deco42/lcb-retrofit/3d-prints/rail_end_cap.stl

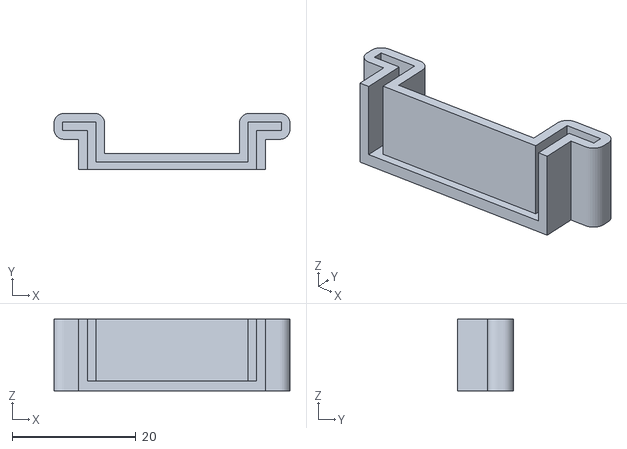
[picture p1: CAD file, 2026-10-27]
3d-prints/rail_end_cap.stl
38.2 x 9.10 x 11.6
