deco42/lcb-retrofit/3d-prints/db37_rail_holder.stl

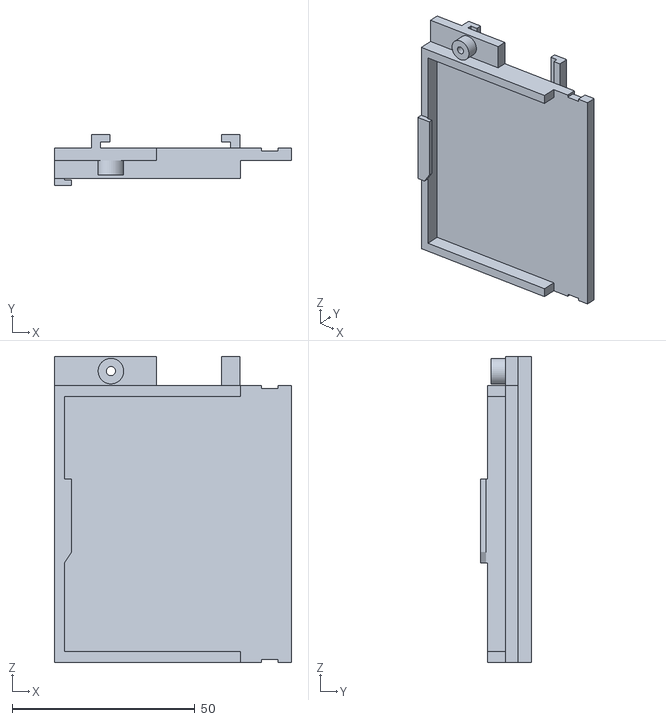
[picture p2: CAD file, 2026-10-27]
3d-prints/db37_rail_holder.stl
65.0 x 13.8 x 83.8
