deco42/lcb-retrofit/testdata/cybelec_link.vectors.txt

# initial state: (raw 0x104, all flags 1, p20 = p28 = 0, station angle 0)
# status
rx 00 ack 1 tx 00 01 00 00 00 00 00 34 00
rx 10 ack 0 tx 10 00
rx 11 ack 0 tx 10 00
rx 12 ack 0 tx 10 00
rx 13 ack 0 tx 10 00
rx 14 ack 0 tx 10 00
rx 15 ack 0 tx 10 00
rx 16 ack 0 tx 10 00
rx 17 ack 0 tx 10 00
rx 18 ack 0 tx 10 00
rx 19 ack 0 tx 10 00
rx 1a ack 0 tx 10 00
rx 1b ack 0 tx 10 00
rx 1c ack 0 tx 10 00
rx 1d ack 0 tx 10 00
rx 1e ack 0 tx 10 00
rx 1f ack 0 tx 10 00
# parameter block 5: p20 = 1000, p28 = 2000, p30 = 0
rx 25 ack 1 tx
rx e8 ack 1 tx
rx 03 ack 1 tx
rx d0 ack 1 tx
rx 07 ack 1 tx
rx 00 ack 1 tx
rx 00 ack 1 tx 25
# parameter block 6: set angle 90.0
rx 26 ack 1 tx
rx 84 ack 1 tx
rx 03 ack 1 tx
rx 00 ack 1 tx
rx 00 ack 1 tx 26
# parameter block 0
rx 20 ack 1 tx
rx 4e ack 1 tx
rx 4c ack 1 tx
rx 52 ack 1 tx
rx 2d ack 1 tx
rx 44 ack 1 tx
rx 4e ack 1 tx
rx 02 ack 1 tx
rx 00 ack 1 tx 20
angle 180 1 1 1
rx 10 ack 0 tx 13 e8
rx 11 ack 0 tx 13 e8
rx 12 ack 0 tx 13 e8
rx 13 ack 0 tx 13 e8
rx 14 ack 0 tx 13 e8
rx 15 ack 0 tx 13 e8
rx 16 ack 0 tx 13 e8
rx 17 ack 0 tx 13 e8
rx 18 ack 0 tx 13 e8
rx 19 ack 0 tx 13 e8
rx 1a ack 0 tx 13 e8
rx 1b ack 0 tx 13 e8
rx 1c ack 0 tx 13 e8
rx 1d ack 0 tx 13 e8
rx 1e ack 0 tx 13 e8
rx 1f ack 0 tx 13 e8
angle 179.75 1 1 1
rx 10 ack 0 tx 13 e8
rx 11 ack 0 tx 13 ea
rx 12 ack 0 tx 13 ea
rx 13 ack 0 tx 13 ea
rx 14 ack 0 tx 13 ea
rx 15 ack 0 tx 13 ea
rx 16 ack 0 tx 13 ea
rx 17 ack 0 tx 13 e8
rx 18 ack 0 tx 13 e8
rx 19 ack 0 tx 13 e8
rx 1a ack 0 tx 13 e8
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
rx 00 ack 1 tx 00 01 00 00 00 00 00 34 00
# DNC block with 0 words: aborted after the word count
rx 30 ack 1 tx
rx 01 ack 1 tx
rx 00 ack 1 tx
rx 36 ack 1 tx
rx 00 ack 1 tx
rx 00 ack 1 tx
rx 00 ack 1 tx
rx 00 ack 1 tx 00 01 00 00 00 00 00 34 00
# status
rx 00 ack 1 tx 00 01 00 00 00 00 00 34 00
