deco42/lcb-retrofit/(commit log)

2026-10-27 Added stl files
    [db37_rail_holder.scad, db37_rail_holder.stl, rail_end_cap.scad, rail_end_cap.stl]
2026-10-28 Add configuration files and initial implementation for setup, sensor, and die parsing
2026-10-28 Add sensor protocol implementation and unit tests
2026-11-04 Add logging and persistence modules with atomic operations and thread safety
2026-11-04 Add HAL and shared modules with threading support and initialization functions
2026-11-04 Add sensor client module for handling sensor communication
2026-11-04 Add I/O thread implementation for managing input/output operations and service requests
2026-11-04 Add main application logic with configuration parsing and thread management
2026-11-04 Add replay testing framework and implement frame comparison tool
2026-11-04 Add README.md with project overview, wiring details, and folder structure
